CUonOrbit/HAB5-OBC-PCB/Data.kicad_sch

## KiCad design Data.kicad_sch (2026-11-03)

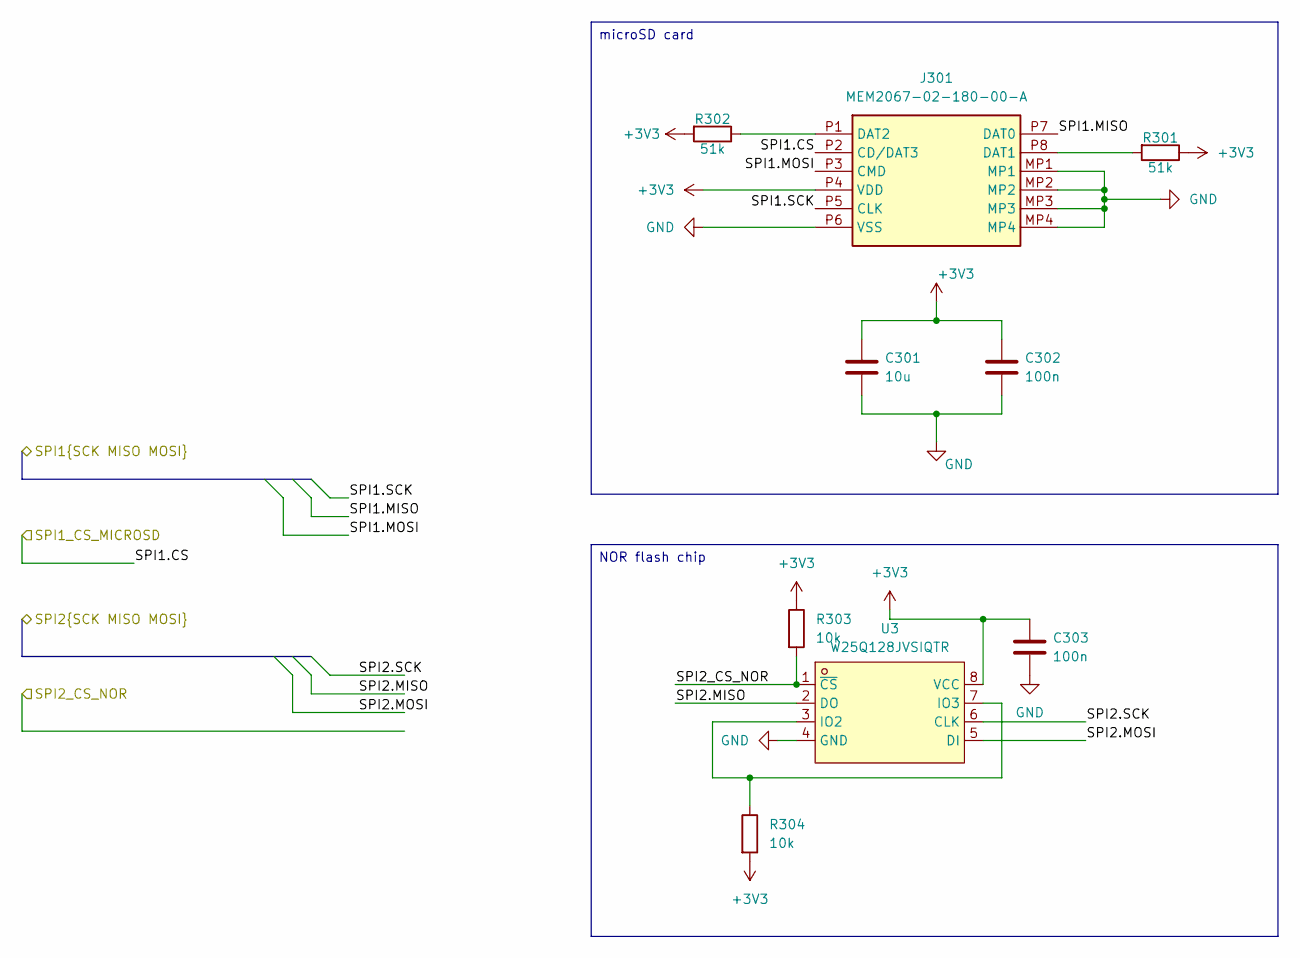
[picture p1: schematic Data.kicad_sch]

Parts:
C301: 10u
C302, C303: 100n
J301: MEM2067-02-180-00-A; MEM20670218000A; Manufacturer_Part_Number MEM2067-02-180-00-A; Mouser Part Number 640-MEM20670218000A
R301, R302: 51k
R303, R304: 10k
U3: W25Q128JVSIQTR; SOIC-8_L5.3-W5.3-P1.27-LS8.0-BL; MPN W25Q128JVSIQ; LCSC Part C97521

Connections:
+3V3: C301.1, C302.1, C303.1, J301.P4 (VDD), R301.1, R302.2, R303.1, R304.2, U3.8 (VCC)
GND: C301.2, C302.2, C303.2, J301.MP1, J301.MP2, J301.MP3, J301.MP4, J301.P6 (VSS), U3.4 (GND)
unnamed: J301.P1 (DAT2), R302.1
unnamed: J301.P8 (DAT1), R301.2
unnamed: R304.1, U3.3 (IO2), U3.7 (IO3)
SPI1.CS: J301.P2 (CD/DAT3)
SPI1.MISO: J301.P7 (DAT0)
SPI1.MOSI: J301.P3 (CMD)
SPI1.SCK: J301.P5 (CLK)
SPI2.MISO: U3.2 (DO)
SPI2.MOSI: U3.5 (DI)
SPI2.SCK: U3.6 (CLK)
SPI2_CS_NOR: R303.2, U3.1 (~CS)

Notes on the sheet:
NOR flash chip
microSD card
