CUonOrbit/HAB5-OBC-PCB/HAB5-OBC.kicad_sch

## KiCad design HAB5-OBC.kicad_sch (2026-11-03)

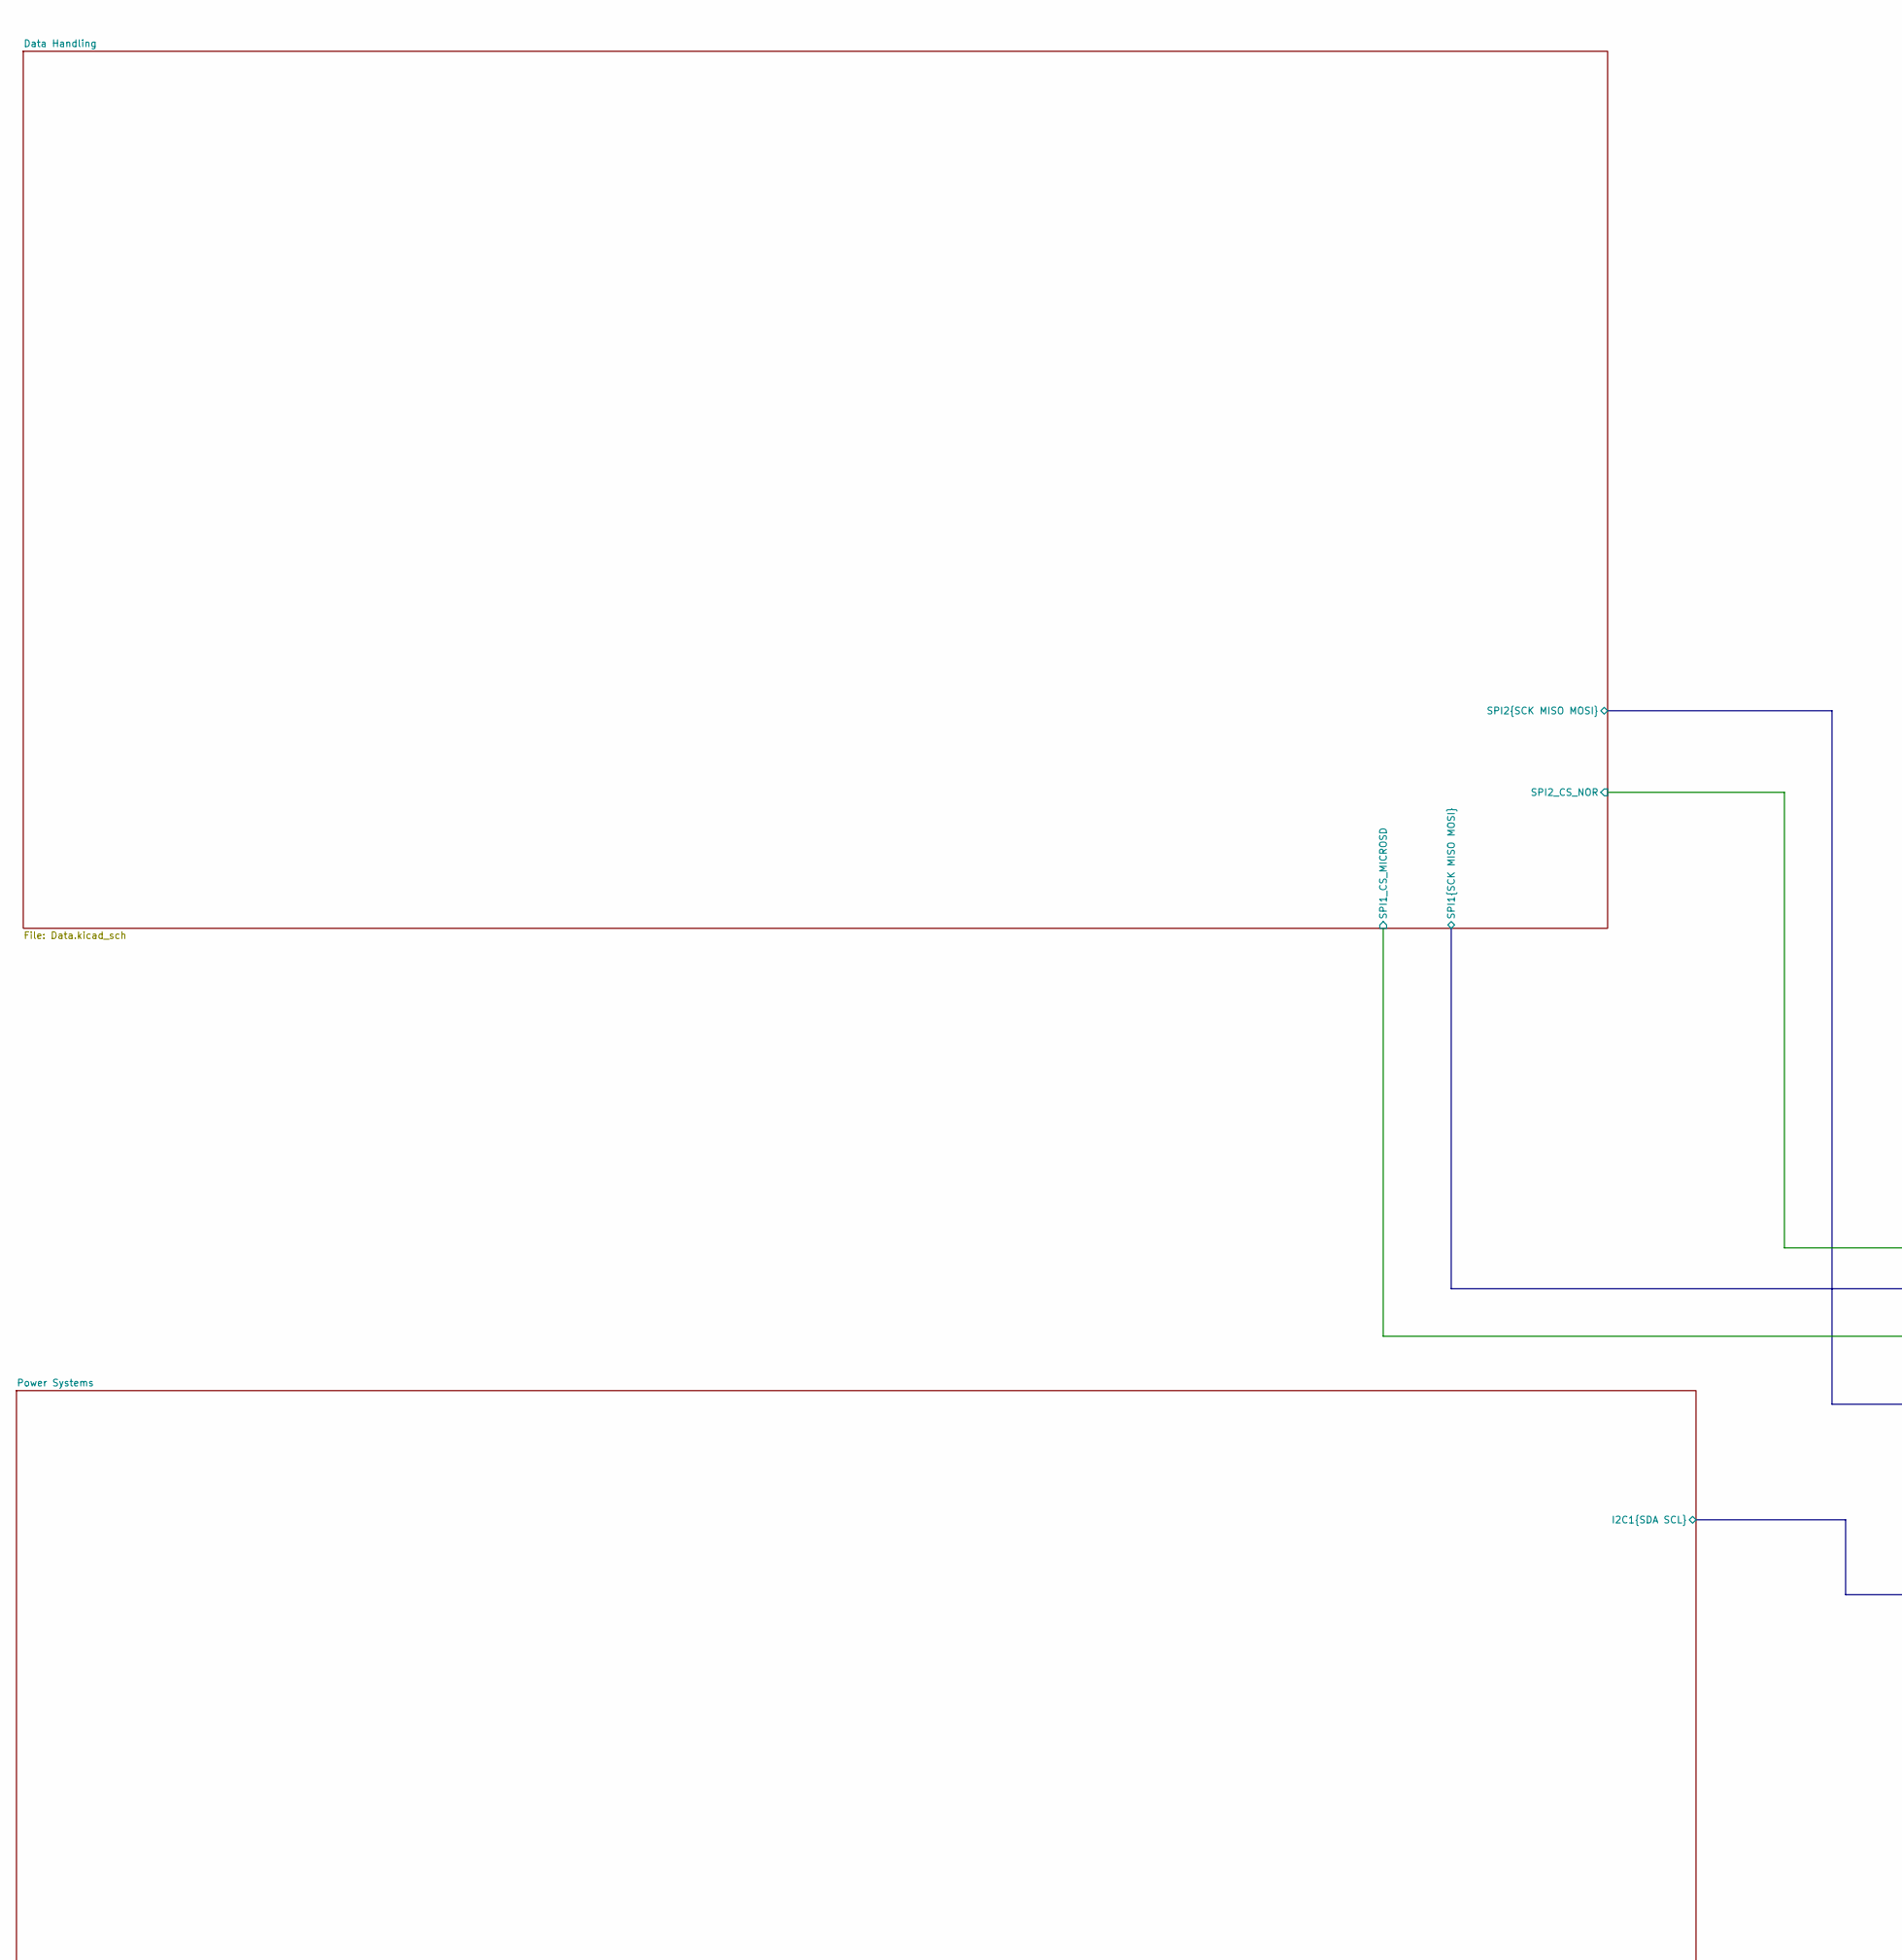
[picture p2: schematic HAB5-OBC.kicad_sch, part in row 1, column 1]

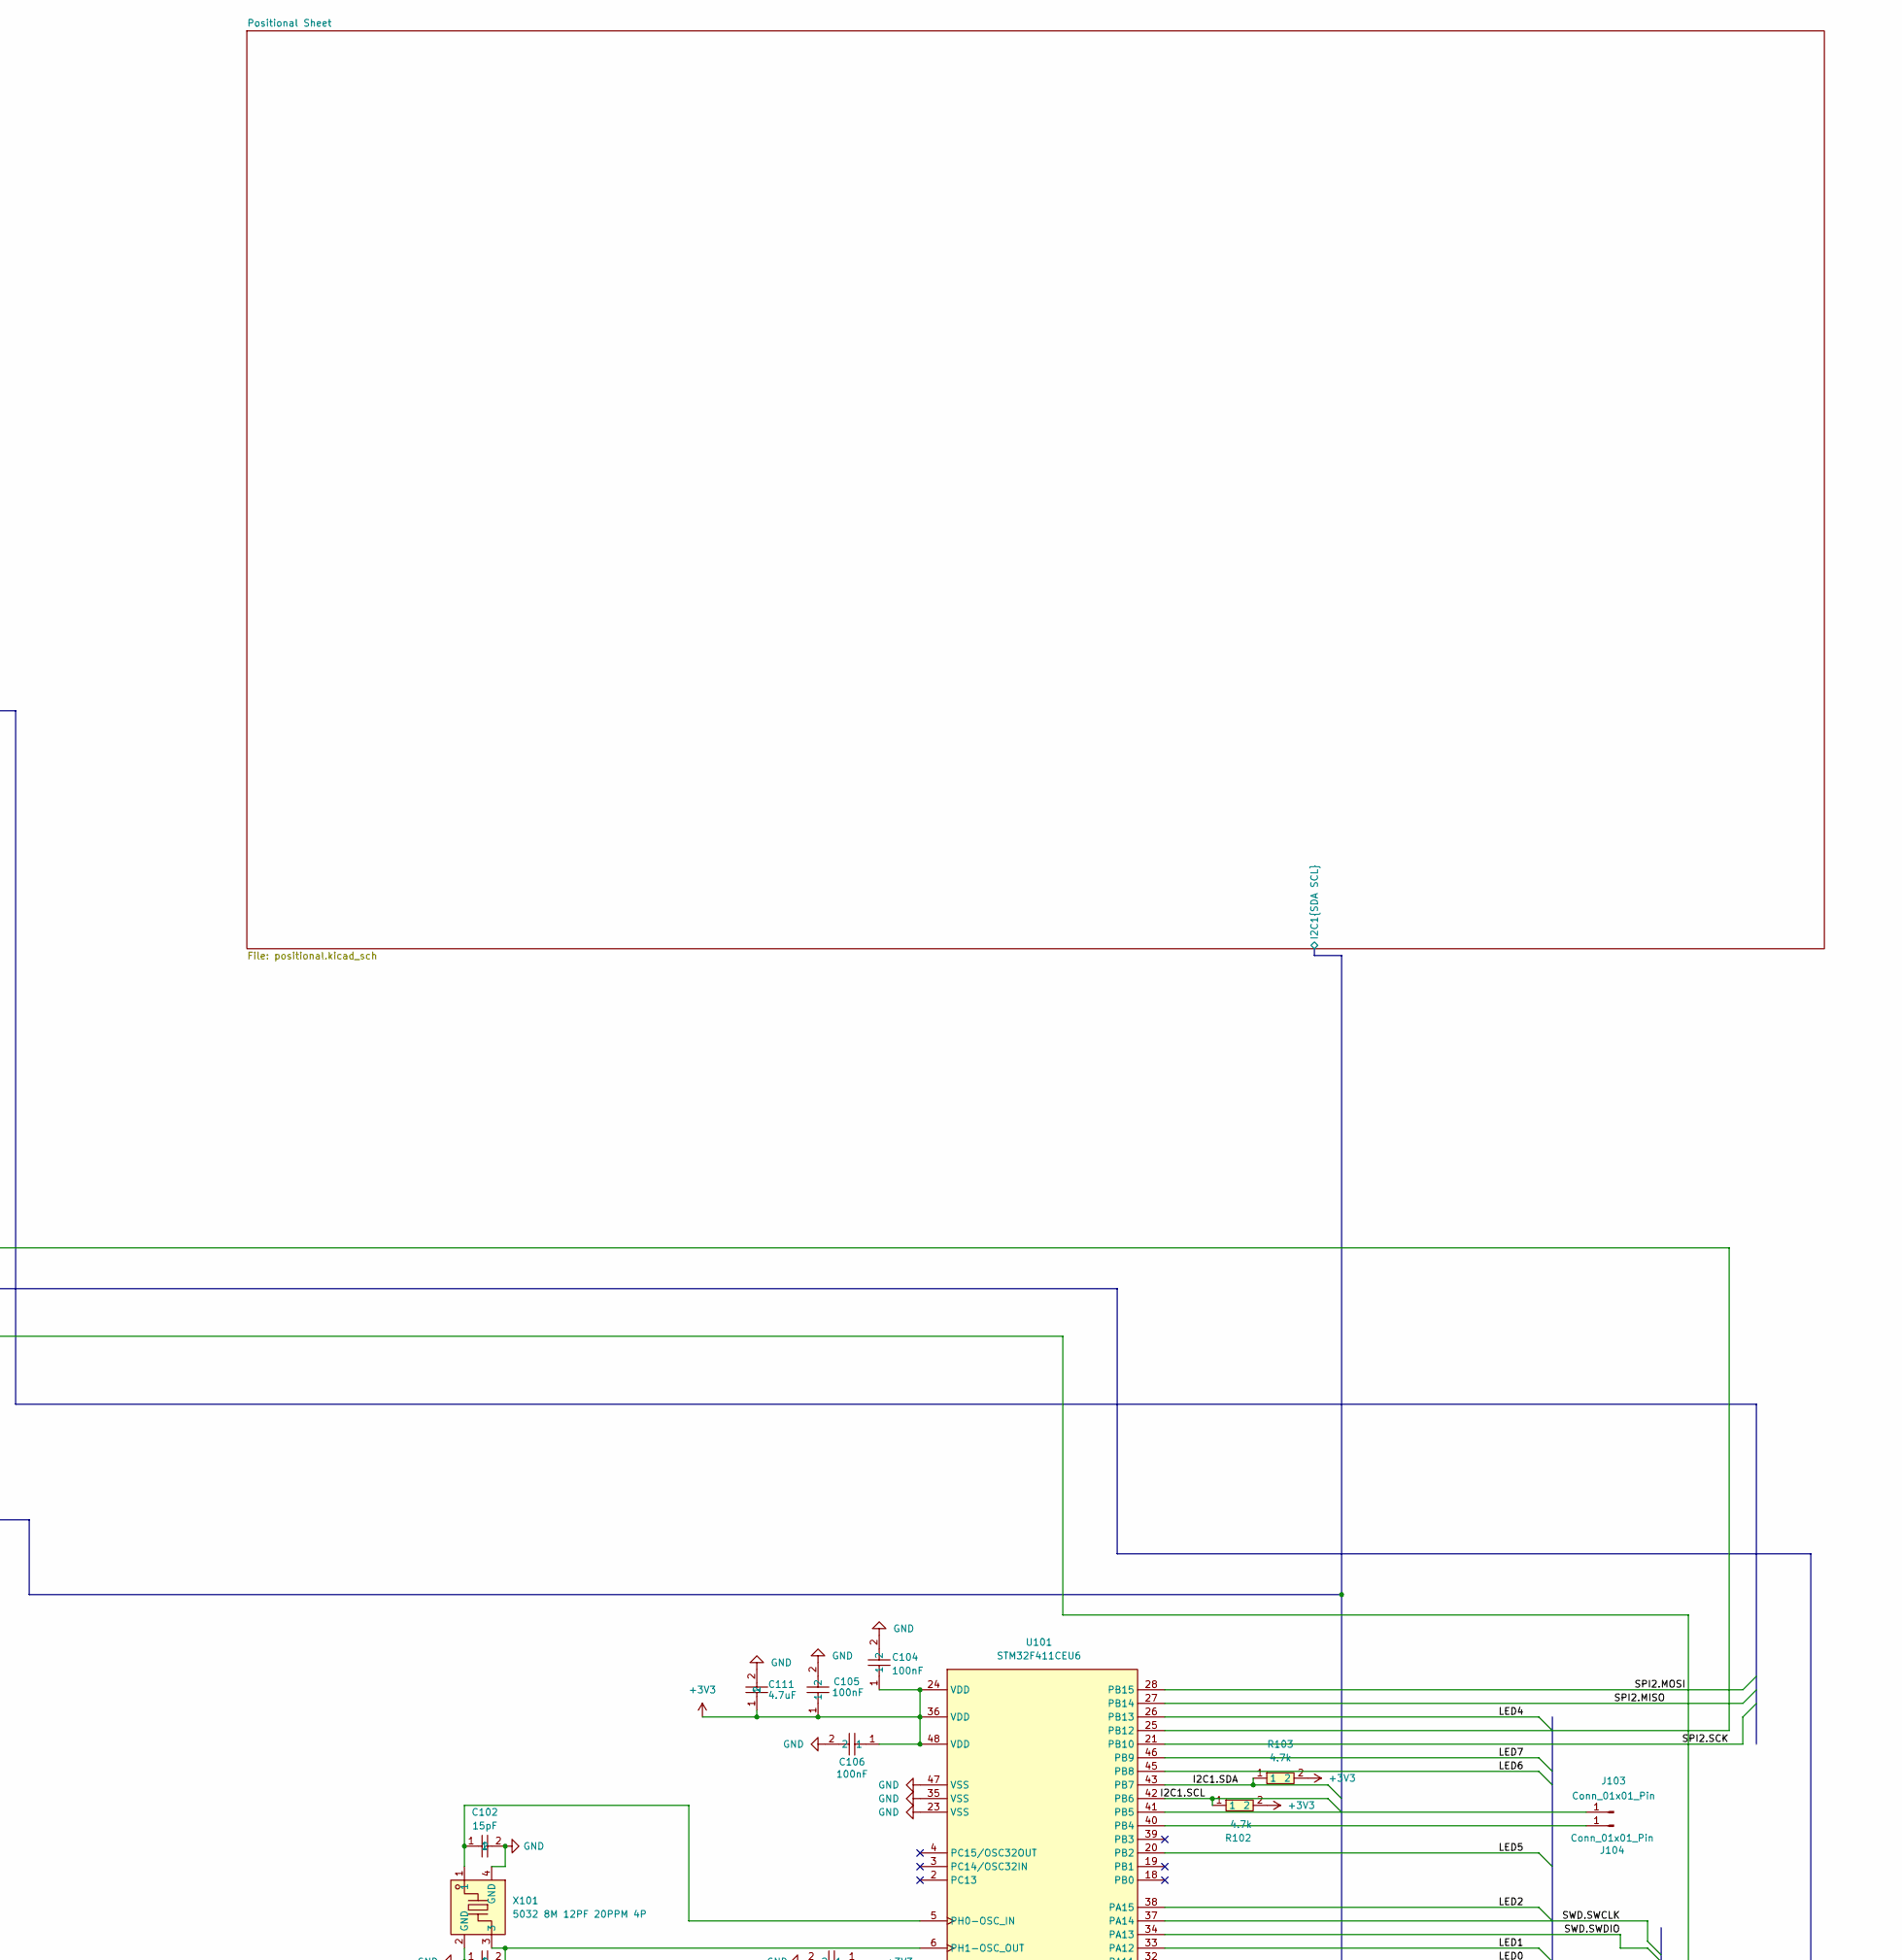
[picture p3: schematic HAB5-OBC.kicad_sch, part in row 1, column 2]

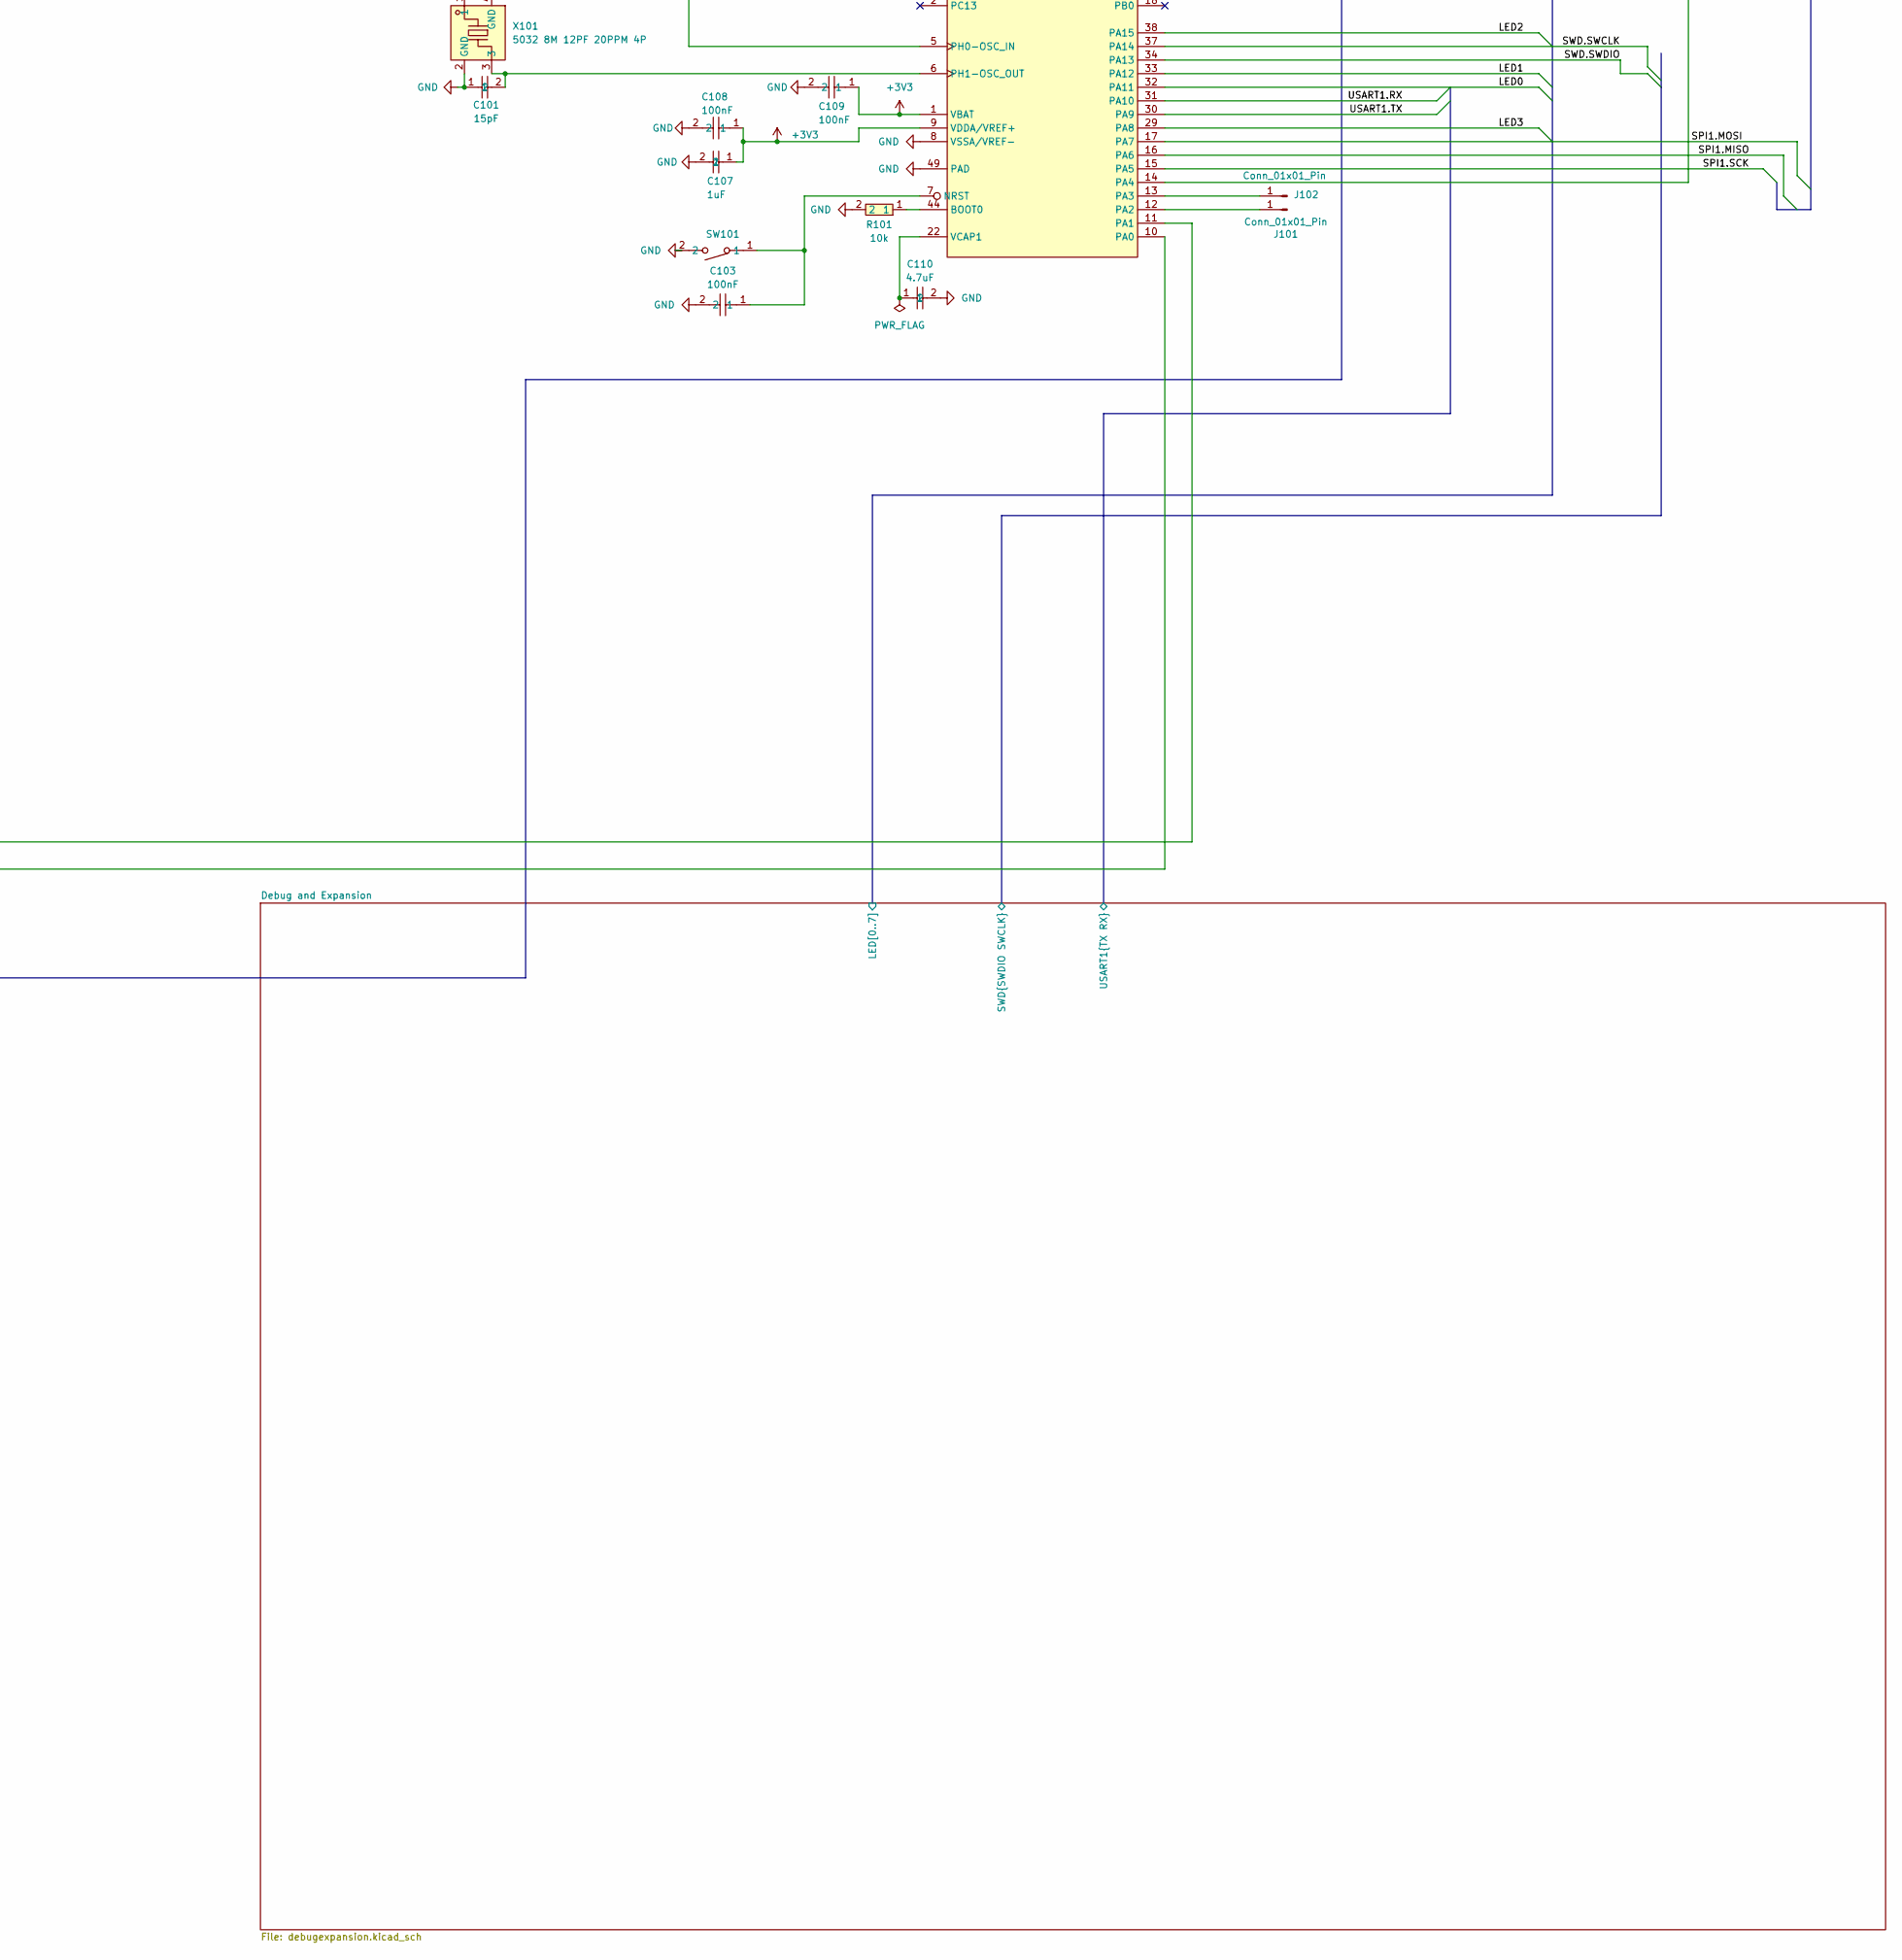
[picture p4: schematic HAB5-OBC.kicad_sch, part in row 2, column 2]

Parts:
C101, C102: 15pF; C0402; MPN 0402CG150J500NT; LCSC Part C1548
C103, C104, C105, C106, C108, C109: 100nF; C0402; MPN CL05B104KO5NNNC; LCSC Part C1525
C107: 1uF; C0805; MPN CL21B105KBFNNNE; LCSC Part C28323
C110, C111: 4.7uF; C1206; MPN 1206B475K500NT; LCSC Part C29823
J101, J102, J103, J104: Conn_01x01_Pin
R101: 10k; R0402; MPN 0402WGF1002TCE; LCSC Part C25744
R102, R103: 4.7k; R0603; MPN 0603WAF4701T5E; LCSC Part C23162
SW101: SW-SMD_L3.9-W3.0-P4.45; MPN TS-1088-AR02016; LCSC Part C720477
U101: STM32F411CEU6; UFQFPN-48_L7.0-W7.0-P0.50-BL-EP; MPN STM32F411CEU6; LCSC Part C60420
X101: 5032 8M 12PF 20PPM 4P; CRYSTAL-SMD_4P-L5.0-W3.2-BL_ECS; MPN 5032 8M 12PF 20PPM 4P; LCSC Part C5181482

Connections:
+3V3: C104.1, C105.1, C106.1, C107.1, C108.1, C109.1, C111.1, R102.2, R103.2, U101.1 (VBAT), U101.9 (VDDA/VREF+), U101.24 (VDD), U101.36 (VDD), U101.48 (VDD)
GND: C101.1, C102.2, C103.2, C104.2, C105.2, C106.2, C107.2, C108.2, C109.2, C110.2, C111.2, R101.2, SW101.2, U101.8 (VSSA/VREF-), U101.23 (VSS), U101.35 (VSS), U101.47 (VSS), U101.49 (PAD), X101.2 (GND), X101.4 (GND)
I2C1.SCL: R102.1, U101.42 (PB6)
I2C1.SDA: R103.1, U101.43 (PB7)
LED0: U101.32 (PA11)
LED1: U101.33 (PA12)
LED2: U101.38 (PA15)
LED3: U101.29 (PA8)
LED4: U101.26 (PB13)
LED5: U101.20 (PB2)
LED6: U101.45 (PB8)
LED7: U101.46 (PB9)
LMT84_OUT: U101.10 (PA0)
NTC_MID: U101.11 (PA1)
unnamed: C101.2, U101.6 (PH1-OSC_OUT), X101.3
unnamed: C102.1, U101.5 (PH0-OSC_IN), X101.1
unnamed: C103.1, SW101.1, U101.7 (NRST)
unnamed: C110.1, U101.22 (VCAP1)
unnamed: J101.1, U101.12 (PA2)
unnamed: J102.1, U101.13 (PA3)
unnamed: J103.1, U101.41 (PB5)
unnamed: J104.1, U101.40 (PB4)
unnamed: R101.1, U101.44 (BOOT0)
SPI1.MISO: U101.16 (PA6)
SPI1.MOSI: U101.17 (PA7)
SPI1.SCK: U101.15 (PA5)
SPI1_CS_MICROSD: U101.14 (PA4)
SPI2.MISO: U101.27 (PB14)
SPI2.MOSI: U101.28 (PB15)
SPI2.SCK: U101.21 (PB10)
SPI2_CS_NOR: U101.25 (PB12)
SWD.SWCLK: U101.37 (PA14)
SWD.SWDIO: U101.34 (PA13)
USART1.RX: U101.31 (PA10)
USART1.TX: U101.30 (PA9)
