CUonOrbit/HAB5-OBC-PCB/debugexpansion.kicad_sch

## KiCad design debugexpansion.kicad_sch (2026-11-03)

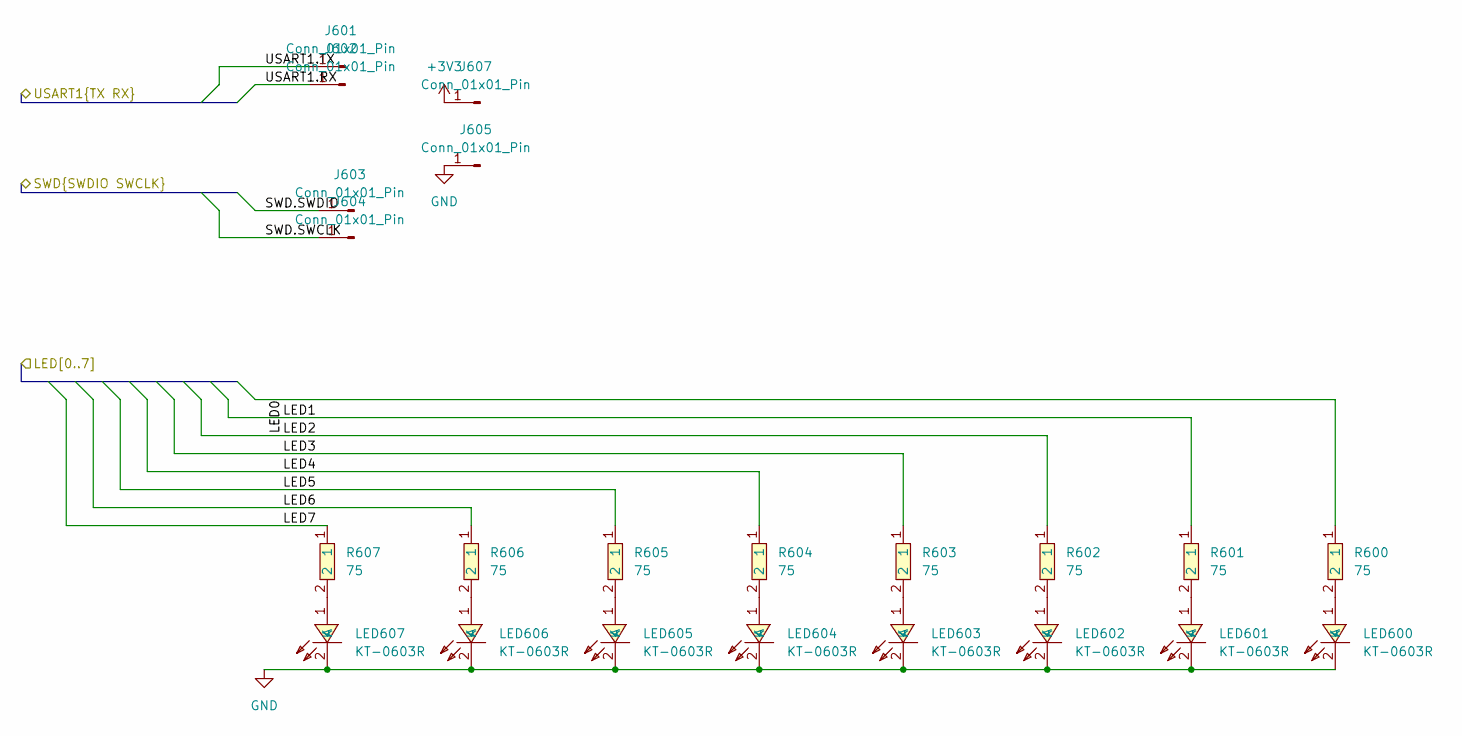
[picture p5: schematic debugexpansion.kicad_sch]

Parts:
J601, J602, J603, J604, J605, J607: Conn_01x01_Pin
LED600, LED601, LED602, LED603, LED604, LED605, LED606, LED607: KT-0603R; LED-SMD_L1.6-W0.8-R-RD; MPN KT-0603R; LCSC Part C2286
R600, R601, R602, R603, R604, R605, R606, R607: 75; R0603; MPN 0603WAF750JT5E; LCSC Part C4275

Connections:
+3V3: J607.1
GND: J605.1, LED600.2 (K), LED601.2 (K), LED602.2 (K), LED603.2 (K), LED604.2 (K), LED605.2 (K), LED606.2 (K), LED607.2 (K)
LED0: R600.1
LED1: R601.1
LED2: R602.1
LED3: R603.1
LED4: R604.1
LED5: R605.1
LED6: R606.1
LED7: R607.1
unnamed: LED600.1 (A), R600.2
unnamed: LED601.1 (A), R601.2
unnamed: LED602.1 (A), R602.2
unnamed: LED603.1 (A), R603.2
unnamed: LED604.1 (A), R604.2
unnamed: LED605.1 (A), R605.2
unnamed: LED606.1 (A), R606.2
unnamed: LED607.1 (A), R607.2
SWD.SWCLK: J604.1
SWD.SWDIO: J603.1
USART1.RX: J602.1
USART1.TX: J601.1
