CUonOrbit/HAB5-OBC-PCB/positional.kicad_sch

## KiCad design positional.kicad_sch (2026-11-03)

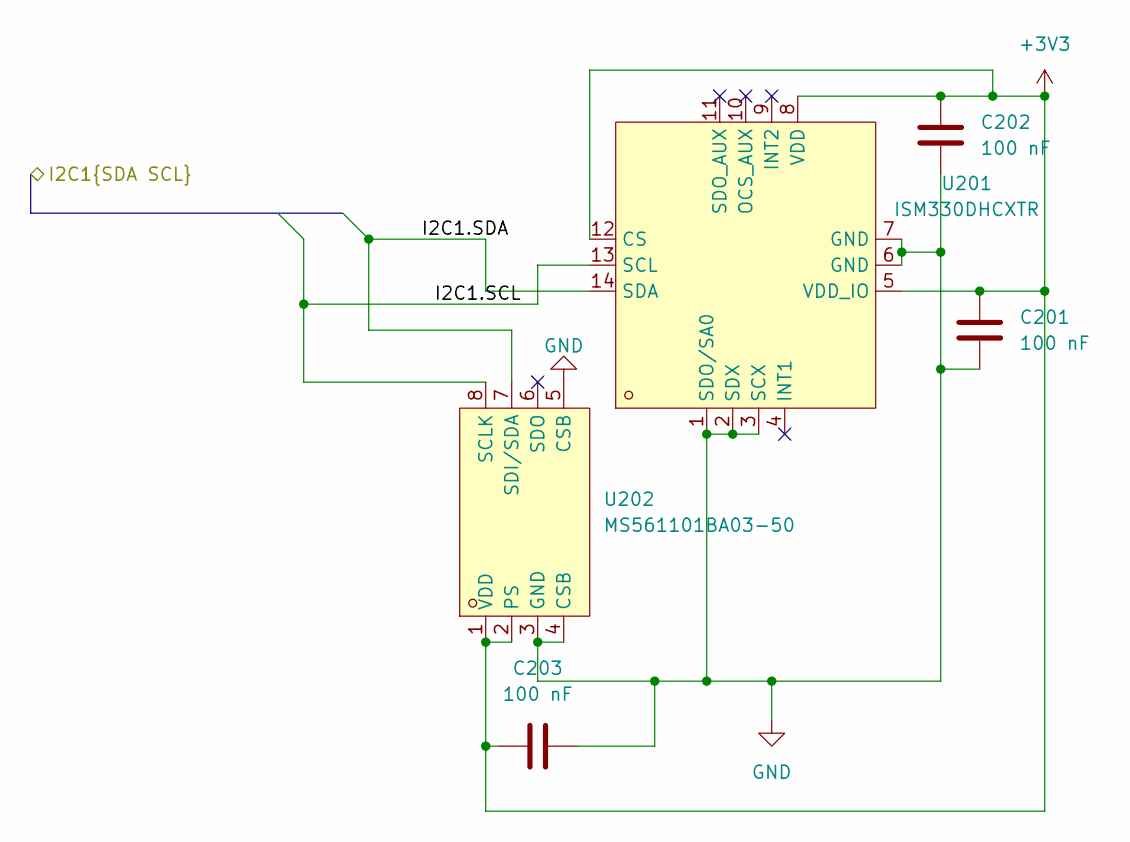
[picture p6: schematic positional.kicad_sch]

Parts:
C201, C202, C203: 100 nF
U201: ISM330DHCXTR; LGA-14_L3.0-W2.5-P0.50-BR; MPN ISM330DHCXTR; LCSC Part C2655101
U202: MS561101BA03-50; SENSORS-SMD_MS5611-01BA03; MPN MS561101BA03-50; LCSC Part C15639

Connections:
+3V3: C201.1, C202.1, C203.1, U201.5 (VDD_IO), U201.8 (VDD), U201.12 (CS), U202.1 (VDD), U202.2 (PS)
GND: C201.2, C202.2, C203.2, U201.1 (SDO/SA0), U201.2 (SDX), U201.3 (SCX), U201.6 (GND), U201.7 (GND), U202.3 (GND), U202.4 (CSB), U202.5 (CSB)
I2C1.SCL: U201.13 (SCL), U202.8 (SCLK)
I2C1.SDA: U201.14 (SDA), U202.7 (SDI/SDA)
