CUonOrbit/HAB5-OBC-PCB/power.kicad_sch

## KiCad design power.kicad_sch (2026-11-03)

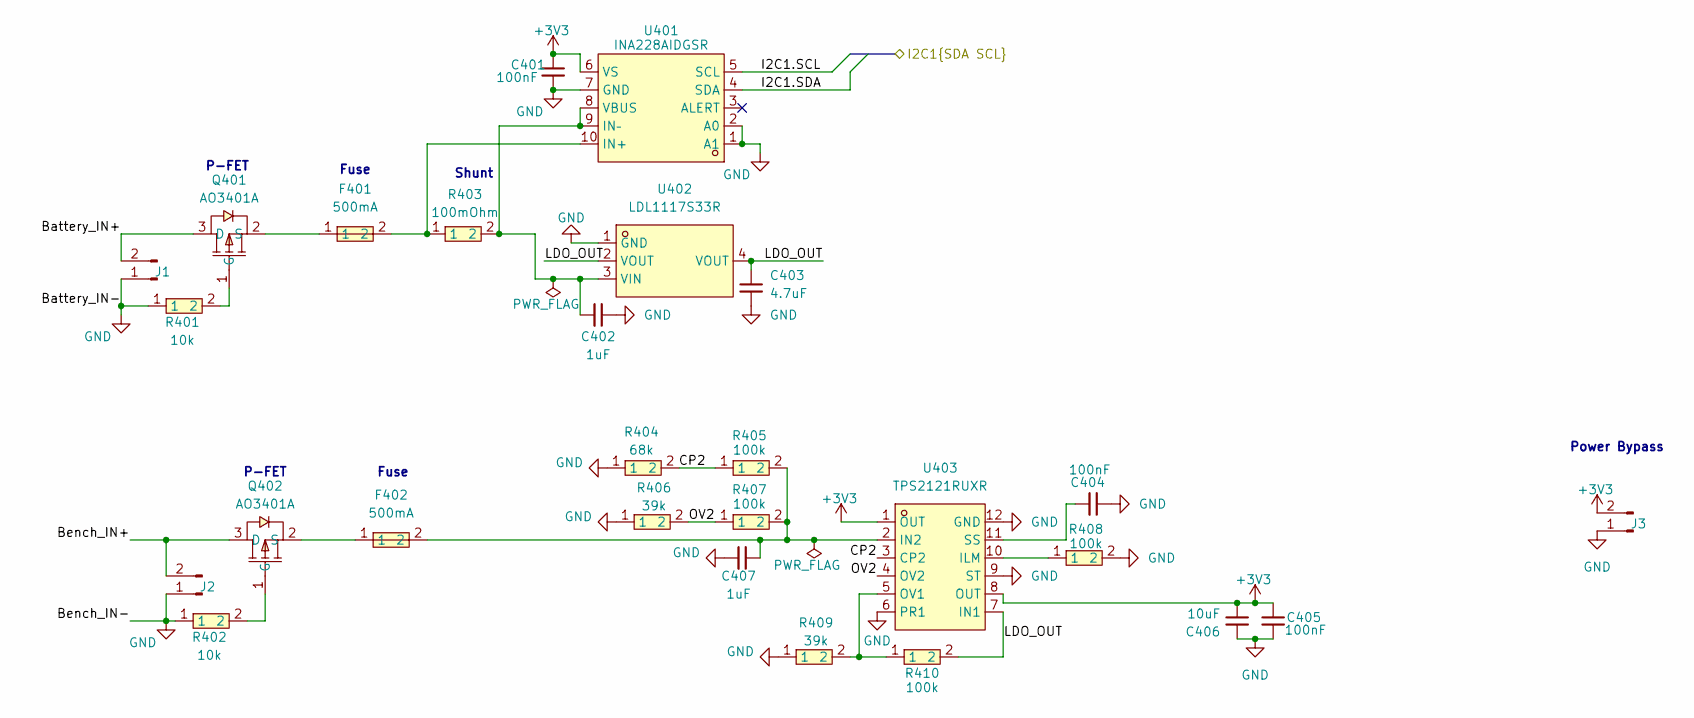
[picture p7: schematic power.kicad_sch]

Parts:
C401, C404, C405: 100nF; C0603; MPN CC0603KRX7R9BB104; LCSC Part C14663
C402, C407: 1uF; C0805; MPN CL21B105KBFNNNE; LCSC Part C28323
C403: 4.7uF; C1206; MPN 1206B475K500NT; LCSC Part C29823
C406: 10uF; C0805; MPN CL21A106KAYNNNE; LCSC Part C15850
F401, F402: 500mA; F1206; MPN 0466.500NRHF; LCSC Part C151133
J1: (no value)
J2, J3: PinHeader_1x02_P2.54mm_Vertical
Q401, Q402: AO3401A; SOT-23_L2.9-W1.3-P1.90-LS2.4-BR; MPN AO3401A; LCSC Part C15127
R401, R402: 10k; R0603; MPN 0603WAF1002T5E; LCSC Part C25804
R403: 100mOhm; R2512; MPN LR2512-2AR100F4; LCSC Part C154690
R404: 68k; R0603; MPN 0603WAF6802T5E; LCSC Part C23231
R405, R407, R408, R410: 100k; R0603; MPN 0603WAF1003T5E; LCSC Part C25803
R406, R409: 39k; R0603; MPN 0603WAF3902T5E; LCSC Part C23153
U401: INA228AIDGSR; VSSOP-10_L3.0-W3.0-P0.50-LS4.9-BL; MPN INA228AIDGSR; LCSC Part C2887910
U402: LDL1117S33R; SOT-223-4_L6.5-W3.5-P2.30-LS7.0-BR; MPN LDL1117S33R; LCSC Part C435835
U403: TPS2121RUXR; VQFN-HR-12_L2.5-W2.0-P0.50-BL; MPN TPS2121RUXR; LCSC Part C485916

Connections:
+3V3: C401.2, C405.1, C406.1, J3.2, U401.6 (VS), U403.1 (OUT), U403.8 (OUT)
Battery_IN+: J1.2, Q401.3 (D)
Bench_IN+: J2.2, Q402.3 (D)
CP2: R404.2, R405.1, U403.3 (CP2)
GND: C401.1, C402.1, C403.1, C404.1, C405.2, C406.2, C407.1, J1.1, J2.1, J3.1, R401.1, R402.1, R404.1, R406.1, R408.2, R409.1, U401.1 (A1), U401.2 (A0), U401.7 (GND), U402.1 (GND), U403.6 (PR1), U403.9 (ST), U403.12 (GND)
I2C1.SCL: U401.5 (SCL)
I2C1.SDA: U401.4 (SDA)
LDO_OUT: C403.2, R410.2, U402.2 (VOUT), U402.4 (VOUT), U403.7 (IN1)
unnamed: C402.2, R403.2, U401.8 (VBUS), U401.9 (IN–), U402.3 (VIN)
unnamed: C404.2, U403.11 (SS)
unnamed: C407.2, F402.2, R405.2, R407.2, U403.2 (IN2)
unnamed: F401.1, Q401.2 (S)
unnamed: F401.2, R403.1, U401.10 (IN+)
unnamed: F402.1, Q402.2 (S)
unnamed: Q401.1 (G), R401.2
unnamed: Q402.1 (G), R402.2
unnamed: R408.1, U403.10 (ILM)
unnamed: R409.2, R410.1, U403.5 (OV1)
OV2: R406.2, R407.1, U403.4 (OV2)

Notes on the sheet:
P-FET
Fuse
Power Bypass
Shunt
