CUonOrbit/HAB5-OBC-PCB/temp.kicad_sch

## KiCad design temp.kicad_sch (2026-11-03)

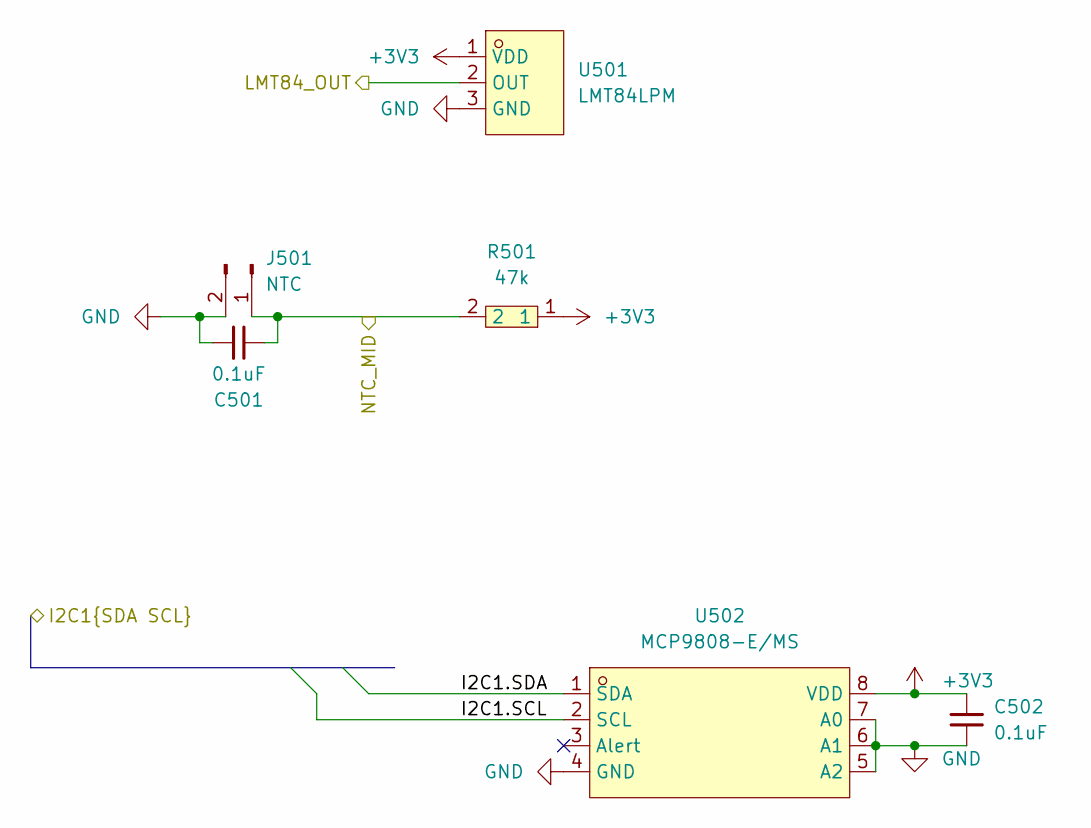
[picture p8: schematic temp.kicad_sch]

Parts:
C501, C502: 0.1uF; C0603; MPN CC0603KRX7R9BB104; LCSC Part C14663
J501: NTC; SOIC-16_3.9x9.9mm_P1.27mm
R501: 47k; R0805; MPN 0805W8F4702T5E; LCSC Part C17713
U501: LMT84LPM; TO-92-3_L4.9-W3.7-P2.54-L; MPN LMT84LPM; LCSC Part C2877244
U502: MCP9808-E/MS; MSOP-8_L3.0-W3.0-P0.65-LS4.9-BL; MPN MCP9808-E/MS; LCSC Part C94847

Connections:
+3V3: C502.1, R501.1, U501.1 (VDD), U502.8 (VDD)
GND: C501.1, C502.2, J501.2, U501.3 (GND), U502.4 (GND), U502.5 (A2), U502.6 (A1), U502.7 (A0)
I2C1.SCL: U502.2 (SCL)
I2C1.SDA: U502.1 (SDA)
LMT84_OUT: U501.2 (OUT)
NTC_MID: C501.2, J501.1, R501.2
