CUonOrbit/HAB5-OBC-PCB/(commit log)

2026-10-12 Initial KiCad project
2026-10-22 Debug LEDs Connected
    let me know if I forgot some detail
2026-10-22 Added Barometer and IMU symbols
2026-10-31 Added sw debug and uart breakouts
2026-10-31 revert kicad proj file
2026-11-01 preliminary positional schematic
2026-11-01 revert kicad proj and add merge_sym.py
2026-11-01 change NOR footprint and update refs
2026-11-01 revert kicad project file
2026-11-02 Power (#4)
    * add P-FET and fuse for battery and bench
    * Add I2C, INA228 + accessories, and other small changes
    * Added extra text for clarity
    * new smaller resistor symbol
    * power2
    Added LDO and MUX
    * rearrange mux resistors and new power bypass
    * fix power to use correct symbol
    * revert kicad proj file
    ---------
2026-11-02 Mcu connections and setup (#5)
    * MCU core functionality
    * Interface Connections
    * change value for real value
    * added NC flags
    * Changed I2C pull up resistors
    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
2026-11-02 Digital, analog, and NTC temp sensors
    * first
    * small modifications
    * change power references and cap placement
    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
2026-11-03 3V3-to-GND Short Fixed (#7)
    * 3v3-to-gnd short fixed
    * revert proj file
    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
2026-11-03 Sync/power mcu positional debug temp (#10)
    * fix passive warning and c101 reference clash
    * fix pin types and ERC error with pwr_flag
    * Add .gitattributes to disable line-ending conversion for STEP files
    ---------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
2026-11-13 Debug Resistor Value Update
    75 -> 220
